javimontero/zenslider-controller-pcb/README.md

# ZenSlider Controller PCB
Motion control controller based on ATMEGA644p microcontroller.
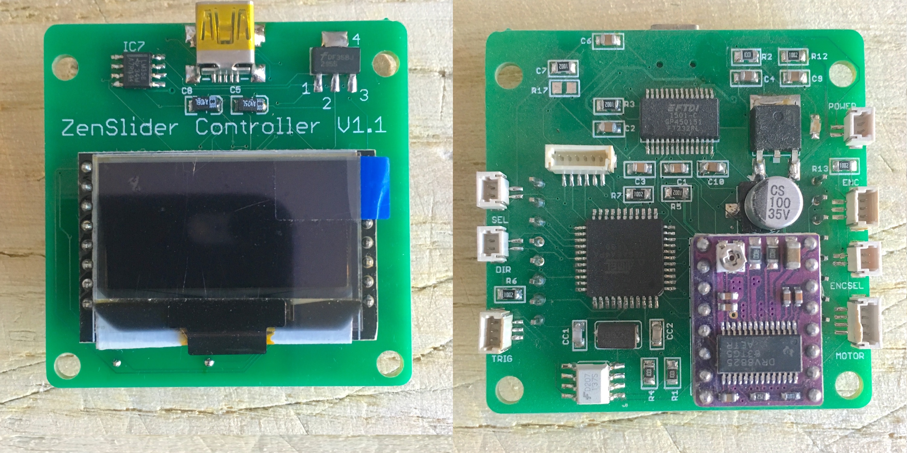
[picture p1: media/controller.jpg]

Eagle schematics and PCB for [ZenSlider and ZenFocus](http://zenslider.com) controller
