javimontero/zenslider-controller-pcb/sliderController_V1.1.pdf

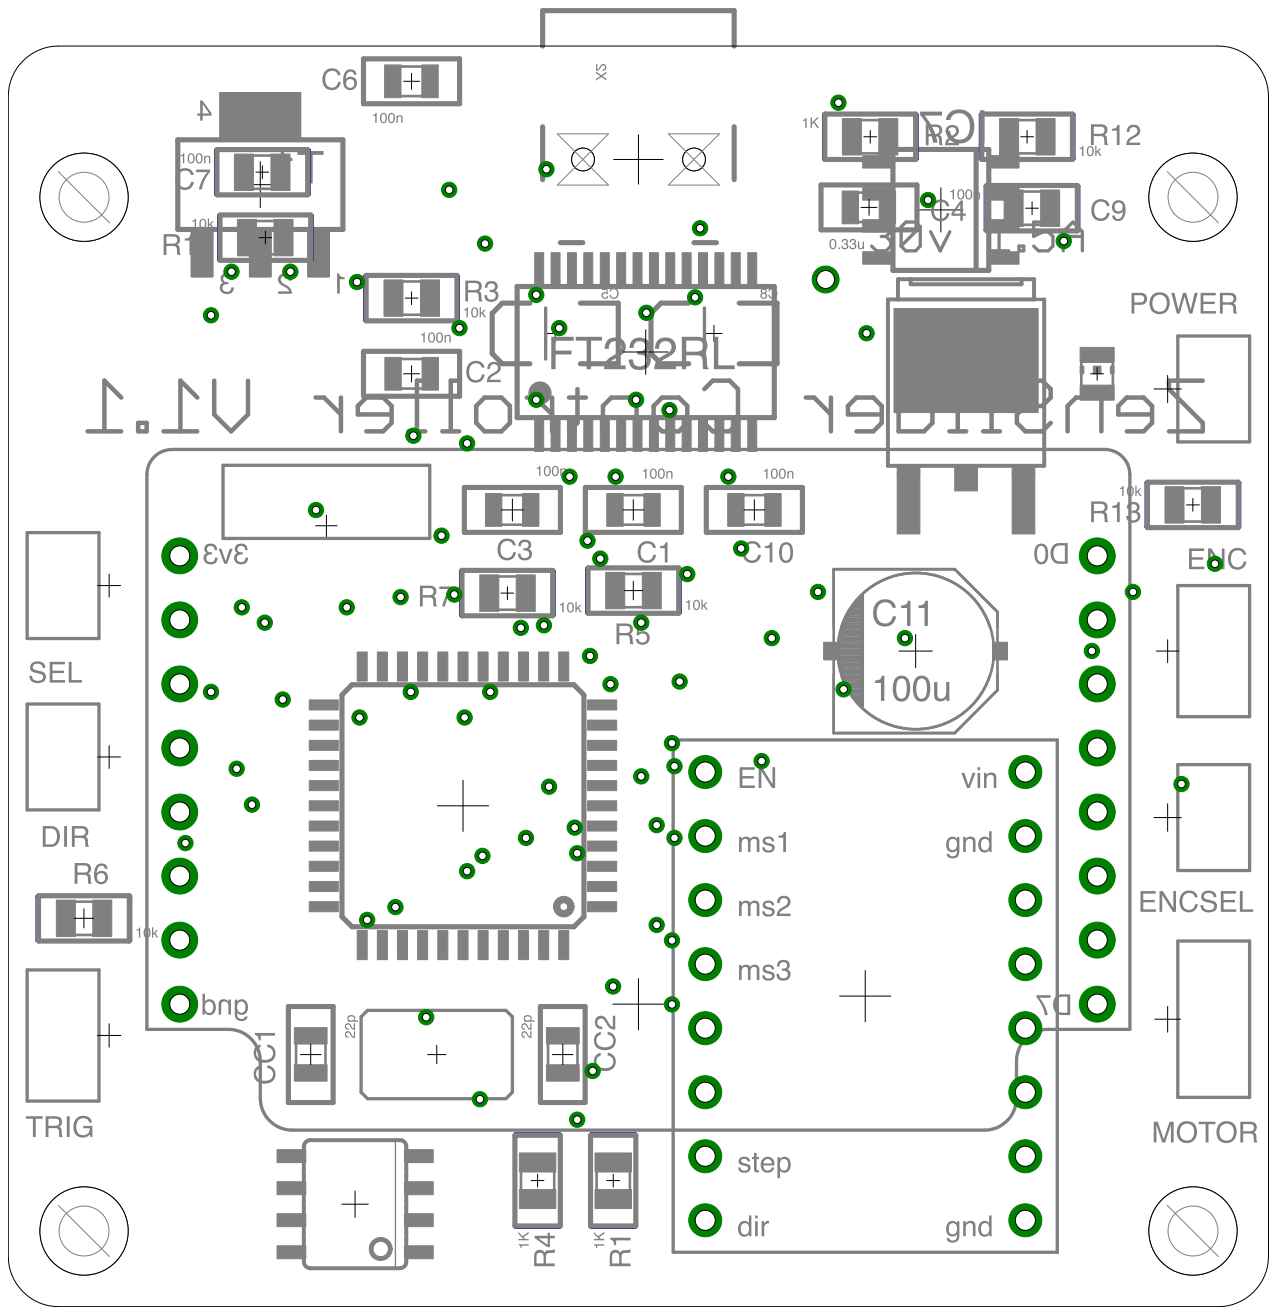
[picture p2: page 1]
