javimontero/zenslider-controller-pcb/sliderController_V1.1.brd

## EAGLE design sliderController_V1.1.brd (2019-03-01)

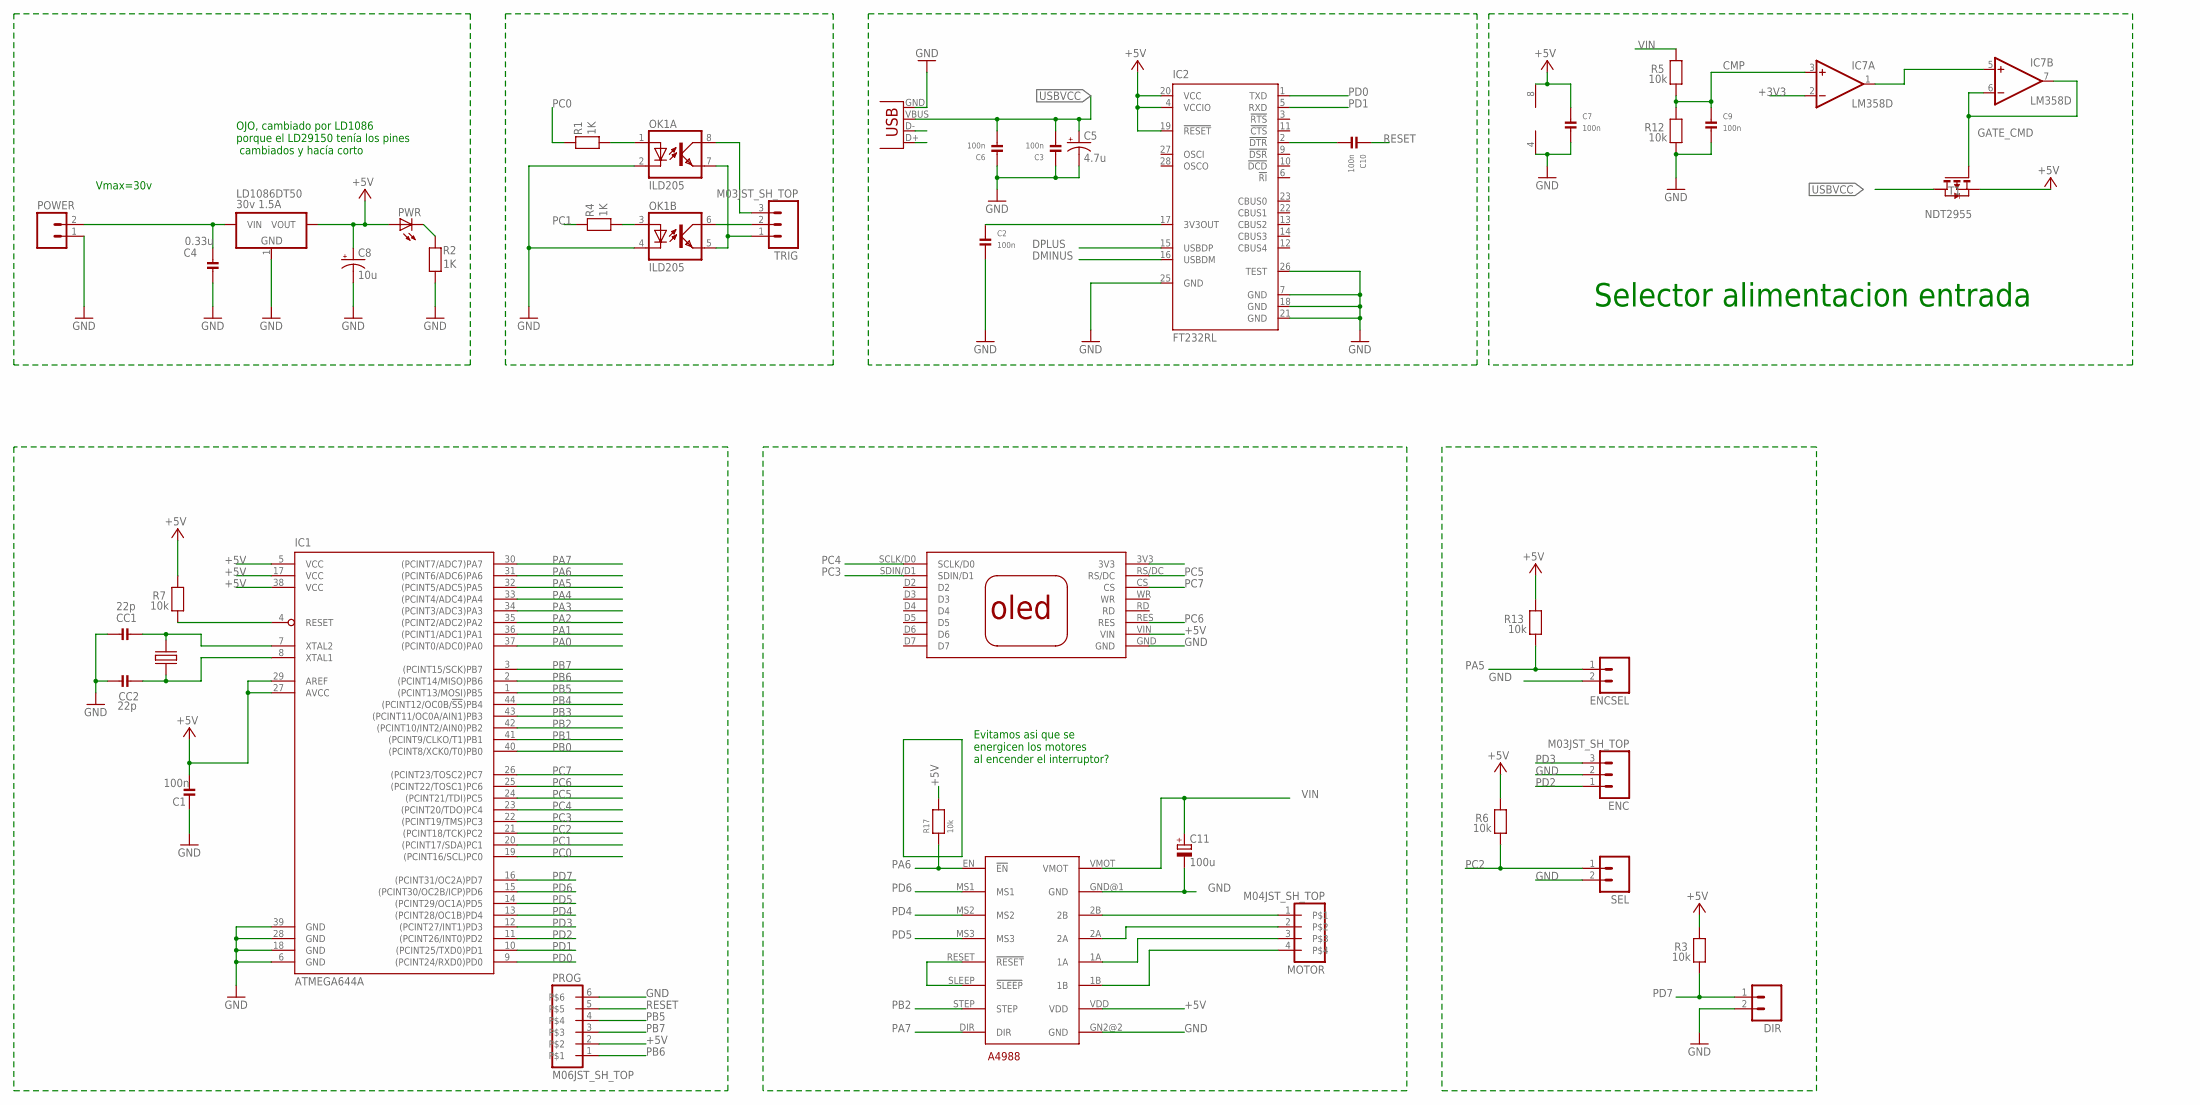
[picture p3: schematic sliderController_V1.1.sch]

Parts:
A4988: STEPSTICK_A4988A4988; STEPSTICK_A4988
C1, C2, C3, C6, C10: 100n; _0805
C4: 0.33u; _0805
C5: 4.7u; EIA3216
C7, C9: 100n; 0805
C8: 10u; EIA3216
C11: 100u; PANASONIC_D
CC1, CC2: 22p; _0805
CRISTAL: CRISTALSMD; CRISTAL5X3.2MM
DIR: M02JST_SH_TOP; JST_1.0_2_TOP
ENC: M03JST_SH_TOP; JST_1.0_3_TOP
ENCSEL: M02JST_SH_TOP; JST_1.0_2_TOP
IC1: ATMEGA644A; TQFP44
IC2: FT232RL; SSOP28
IC7: LM358D; SO08
LD1086DT50: 30v 1.5A; DPAK
MOTOR: M04JST_SH_TOP; JST_1.0_4_TOP
OK1: ILD205; SOIC08
POWER: M02JST_SH_TOP; JST_1.0_2_TOP
PROG: M06JST_SH_TOP; JST_1.0_6_TOP
PWR: LEDCHIP-LED0805; CHIP-LED0805
R1, R2, R4: 1K; 0805
R3, R5, R6, R7, R12, R13, R17: 10k; 0805
SEL: M02JST_SH_TOP; JST_1.0_2_TOP
T1: NDT2955; SOT223
TRIG: M03JST_SH_TOP; JST_1.0_3_TOP
U$3: OLEDOLED1.3"; OLED1.3"
X2: USBSMD; USB-MINIB

Connections:
+3V3: C2.1, IC2.17 (3V3OUT), IC7.2 (-IN)
+5V: A4988.VDD, C1.2, C7.1, C8.A (+), IC1.5 (VCC), IC1.17 (VCC), IC1.27 (AVCC), IC1.29 (AREF), IC1.38 (VCC), IC2.4 (VCCIO), IC2.19 (!RESET), IC2.20 (VCC), IC7.8 (V+), LD1086DT50.2 (VOUT), PROG.2, PWR.A, R3.2, R6.2, R7.2, R13.2, R17.2, T1.3 (S), U$3.VIN
CMP: C9.1, IC7.3 (+IN), R5.1, R12.2
DMINUS: IC2.16 (USBDM), X2.D-
DPLUS: IC2.15 (USBDP), X2.D+
GATE_CMD: IC7.6 (-IN), IC7.7 (OUT), T1.1 (G)
GND: A4988.GN2@2 (GND), A4988.GND@1 (GND), C1.1, C2.2, C3.1, C4.1, C5.C (-), C6.1, C7.2, C8.C (-), C9.2, C11.-, CC1.1, CC2.1, DIR.2, ENC.2, ENCSEL.2, IC1.6 (GND), IC1.18 (GND), IC1.28 (GND), IC1.39 (GND), IC2.7 (GND), IC2.18 (GND), IC2.21 (GND), IC2.25 (GND), IC2.26 (TEST), IC7.4 (V-), LD1086DT50.1 (GND), OK1.2 (C), OK1.4 (C), POWER.1, PROG.6, R2.2, R12.1, SEL.2, U$3.GND, X2.GND
unnamed: C10.2, IC2.2 (!DTR)
unnamed: PWR.C, R2.1
unnamed: CC1.2, CRISTAL.B, IC1.7 (XTAL2)
unnamed: A4988.RESET (!RESET), A4988.SLEEP (!SLEEP)
unnamed: OK1.1 (A), R1.2
unnamed: OK1.8 (COL), TRIG.3
unnamed: OK1.6 (COL), TRIG.2
unnamed: OK1.5 (EMIT), OK1.7 (EMIT), TRIG.1
unnamed: A4988.2B, MOTOR.1
unnamed: CC2.2, CRISTAL.A, IC1.8 (XTAL1)
unnamed: OK1.3 (A), R4.2
unnamed: A4988.2A, MOTOR.2
unnamed: A4988.1A, MOTOR.3
unnamed: A4988.1B, MOTOR.4
unnamed: IC7.1 (OUT), IC7.5 (+IN)
PA0: IC1.37 ((PCINT0/ADC0)PA0)
PA1: IC1.36 ((PCINT1/ADC1)PA1)
PA2: IC1.35 ((PCINT2/ADC2)PA2)
PA3: IC1.34 ((PCINT3/ADC3)PA3)
PA4: IC1.33 ((PCINT4/ADC4)PA4)
PA5: ENCSEL.1, IC1.32 ((PCINT5/ADC5)PA5), R13.1
PA6: A4988.EN (!EN), IC1.31 ((PCINT6/ADC6)PA6), R17.1
PA7: A4988.DIR, IC1.30 ((PCINT7/ADC7)PA7)
PB0: IC1.40 ((PCINT8/XCK0/T0)PB0)
PB1: IC1.41 ((PCINT9/CLKO/T1)PB1)
PB2: A4988.STEP, IC1.42 ((PCINT10/INT2/AIN0)PB2)
PB3: IC1.43 ((PCINT11/OC0A/AIN1)PB3)
PB4: IC1.44 ((PCINT12/OC0B/!SS!)PB4)
PB5: IC1.1 ((PCINT13/MOSI)PB5), PROG.4
PB6: IC1.2 ((PCINT14/MISO)PB6), PROG.1
PB7: IC1.3 ((PCINT15/SCK)PB7), PROG.3
PC0: IC1.19 ((PCINT16/SCL)PC0), R1.1
PC1: IC1.20 ((PCINT17/SDA)PC1), R4.1
PC2: IC1.21 ((PCINT18/TCK)PC2), R6.1, SEL.1
PC3: IC1.22 ((PCINT19/TMS)PC3), U$3.SDIN/D1
PC4: IC1.23 ((PCINT20/TDO)PC4), U$3.SCLK/D0
PC5: IC1.24 ((PCINT21/TDI)PC5), U$3.RS/DC
PC6: IC1.25 ((PCINT22/TOSC1)PC6), U$3.RES
PC7: IC1.26 ((PCINT23/TOSC2)PC7), U$3.CS
PD0: IC1.9 ((PCINT24/RXD0)PD0), IC2.1 (TXD)
PD1: IC1.10 ((PCINT25/TXD0)PD1), IC2.5 (RXD)
PD2: ENC.1, IC1.11 ((PCINT26/INT0)PD2)
PD3: ENC.3, IC1.12 ((PCINT27/INT1)PD3)
PD4: A4988.MS2, IC1.13 ((PCINT28/OC1B)PD4)
PD5: A4988.MS3, IC1.14 ((PCINT29/OC1A)PD5)
PD6: A4988.MS1, IC1.15 ((PCINT30/OC2B/ICP)PD6)
PD7: DIR.1, IC1.16 ((PCINT31/OC2A)PD7), R3.1
RESET: C10.1, IC1.4 (RESET), PROG.5, R7.1
USBVCC: C3.2, C5.A (+), C6.2, T1.2 (D), X2.VBUS
VIN: A4988.VMOT, C4.2, C11.+, LD1086DT50.3 (VIN), POWER.2, R5.2

Notes on the sheet:
Vmax=30v
OJO, cambiado por LD1086 porque el LD29150 tenía los pines cambiados y hacía corto
Evitamos asi que se energicen los motores al encender el interruptor?
Selector alimentacion entrada

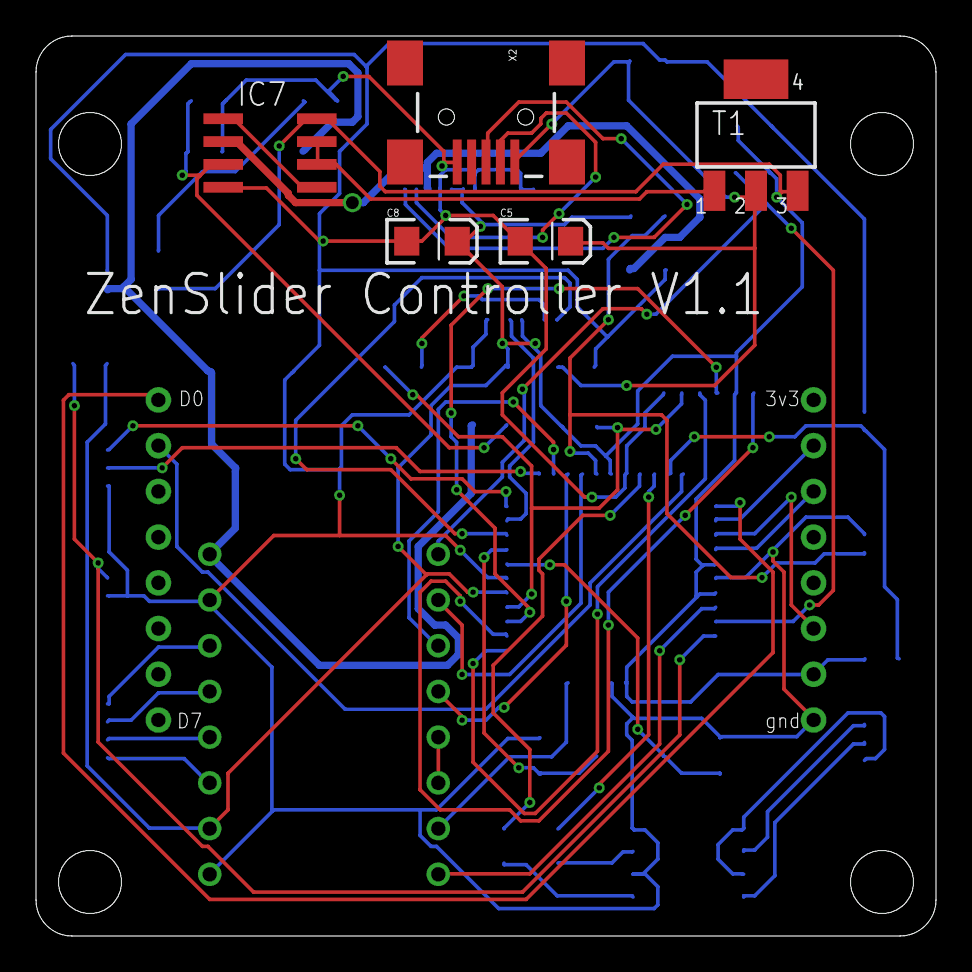
[picture p4: board sliderController_V1.1.brd from above]

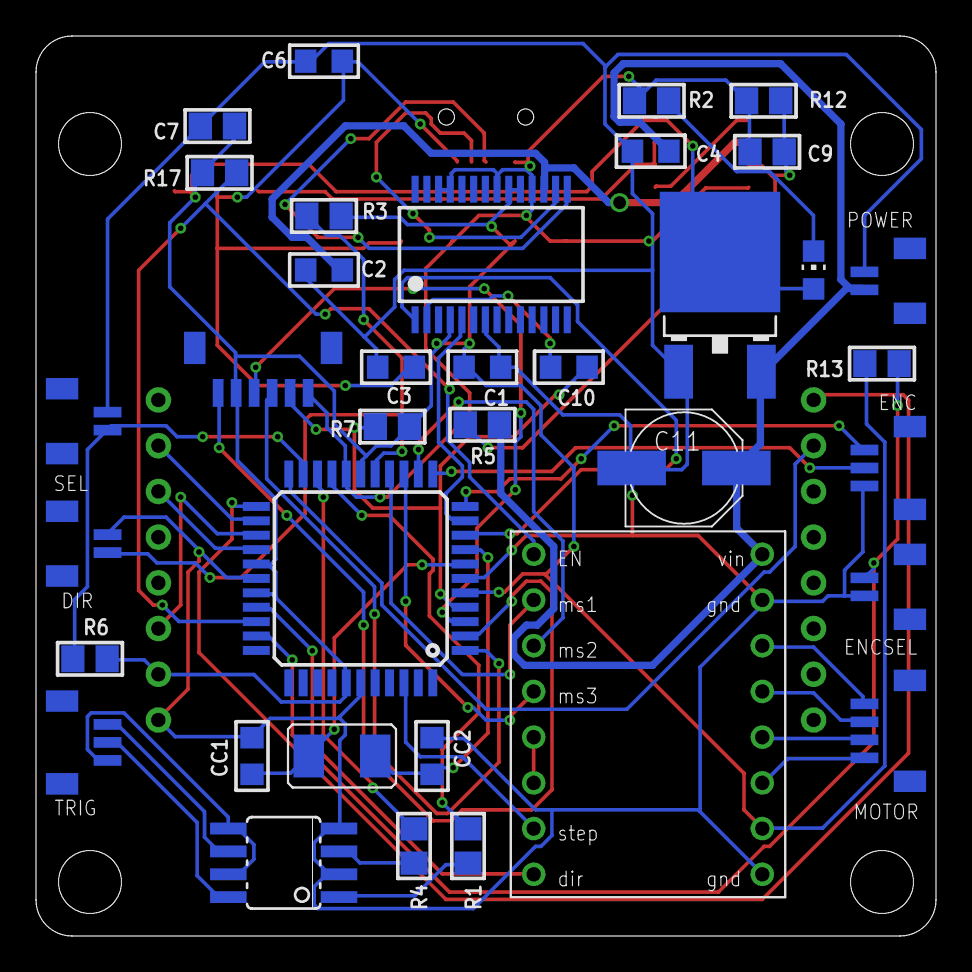
[picture p5: board sliderController_V1.1.brd from below]

Board: 2 copper layers, 50.0 x 50.0 mm, 42 parts (36 on the bottom side), 48 nets.
